HastuneMiku0321/dkmaiproj/(commit log)

2022-10-21 上传本地文件
2022-10-21 更新总览
2022-10-21 上传图片
2022-10-21 更正元素位置
2022-10-21 修正换行符
2022-10-22 链接状态更新
